jesus-cf/Curio_PnP/README.md

# Curio_PnP
Using a Silhouette Curio as a surface mount pick and place machine
