jesus-cf/Curio_PnP/(commit log)

2021-07-20 Added menu entries and push buttons for several commands.
2021-07-21 Re-organized Arduino code.
